JorgeNunono/umdk-onepcb/README.md

# umdk-onepcb
 Single board implementation of makestuff's original combo of the LX9 FPGA development board and the UMDKv2-LX9 adapter to the MegaDrive

Project made in Altium, production files and PDF schematics in the 'Generate Files' subfolder
