JorgeNunono/umdk-onepcb/Generate Files/BOM/Bill of Materials XLS-UMDK.xlsx

Designator | Quantity | Manufacturer | Manufacturer Part Number | Footprint | Comment | Value | Voltage
C1, C2, C4, C6, C11, C38, C39 | 7 | Kemet | C1210C107M9PAC7800 | C-1210 | 100uF | 100uF | 6.3V
C3, C5, C7, C8, C59, C60, C61, C62, C63 | 9 | Kemet | C0603C475K9PAC7867 | C-0603 | 4.7uF | 4.7uF | 6.3V
C9, C13, C14, C15, C16, C17, C18, C19, C20, C22, C24, C25, C26, C27, C28, C29, C30, C31, C32, C33, C34, C35, C36, C37, C40, C41, C42, C43, C44, C45, C46, C47, C48, C49, C50, C51, C52, C53, C54, C55, C56, C57, C58 | 43 | Kemet | C0402C105K9PAC7867 | C-0402 | 1uF | 1uF | 6.3V
C21, C23 | 2 | Kemet | C0402C220J5GACTU | C-0402 | 22pF | 22pF | 50V
D1, D2 | 2 | ST Microelectronics | STPS2L30A | D-SMA | B230A-13-F
J1 | 1 | Wuerth Elektronik | 632723300011 | 632723300011 | 632723300011
J2 | 1 | Molex | 5027740891 | 5027740891 | 5027740891
L1, L2, L3 | 3 | Wuerth Elektronik | 74438336033 | I-1212 | 3.3uH | 3.3uH
Q1, Q2 | 2 | Nexperia | 2N7002,215 | T-SOT23 | 2N7002
R1, R5 | 2 | Vishay | CRCW04021K50FKEDC | R-0402 | 1.5k | 1.5k
R2, R7 | 2 | Vishay | CRCW04026K80FKEDC | R-0402 | 6.8k | 6.8k
R3, R4, R6, R8, R9, R10, R11, R12, R19, R20 | 10 | Vishay | CRCW04023K30FKEDC | R-0402 | 3.3k | 3.3k
R13, R17 | 2 | Vishay | CRCW04021R00FKEDC | R-0402 | 1R | 1R
R16 | 1 | Vishay | CRCW0402220RFKEDC | R-0402 | 220R | 220R
R21, R22, R23 | 3 | Vishay | CRCW04025K10FKEDC | R-0402 | 5.1k | 5.1k
RP1, RP2, RP3, RP4 | 4 | Bourns | CAT16-271J4LF | RP4-1206 | 270R | 270R
U1 | 1 | Richtek USA Inc. | RT8035GQW | 10SON | RT8035
U2, U5 | 2 | Nexperia | 74LVC16245ADGG,118 | 1201-01_L | 74LVC16245ADGG,118
U3 | 1 | Microchip | 24LC128-E/SN | SOIC-SN8_N | 24LC128-E/SN
U4 | 1 | Cypress | CY7C68014A-56PVXC | O56_N | CY7C68014A-56PVXC
U6 | 1 | Xilinx | XC6SLX9-3TQG144C | TQG144_N | XC6SLX9-3TQG144C
U7 | 1 | Nexperia | 74ALVC164245DGG:11 | 1201-01_L | 74LVC16245ADGG,118
U8 | 1 | Micron | MT48LC8M16A2P-6A | MICT-P-54_N | MT48LC8M16A2P-6A |  | 3.3V
U9 | 1 | Micron | M25P40-VMN6P | MICT-MN-8_N | M25P40-VMN6P |  | 2.3V-3.6V
U10 | 1 | Texas Instruments | SN74LVC1G00DBVT | DBV0005A_N | SN74LVC1G00DBVT
U11 | 1 | Onsemi | MC74VHC4053DTR2G | 948F-01_N | MC74VHC4053DTR2G
Y1 | 1 | CTS-Frequency Controls | ATS240BSM-1E | CRYSTAL_HC49-US-SM | 24MHz
