JorgeNunono/umdk-onepcb/(list of files, drawings)

Other design files:
632723300011.PcbLib
Discretes.PcbLib
Discretes.SchLib
JTAG Headers.PcbLib
MD Edge Connectors.PcbLib
RT8035.PcbLib
SDCardSlot.PcbLib
UMDK.PrjPcb
UMDK.SchDoc
UMDK.SchLib
